arede22/voice-activated-car/README.md

# Voice Activated Car

Part of UC-Berkeley lab curriculum of EE16B to use newly learned applications of SVD and PCA along with circuit building to culminate in a voice-activated car. 

All relevant information in comprehensive lab report pdf.

<div align="center">
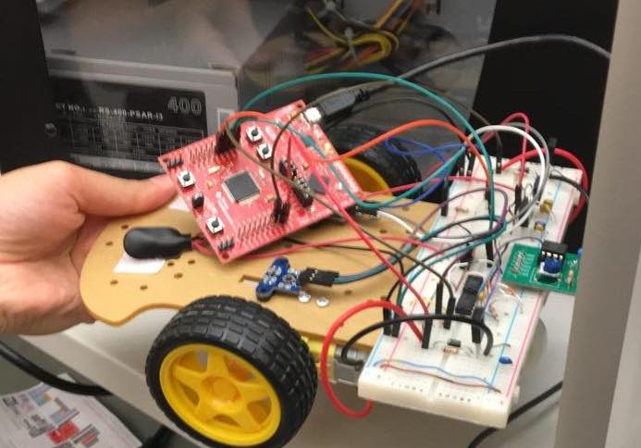
[picture p1: images/charlie.jpg]
  

  <p> Our last day with our robot, Charlie! </p>
</div>

<div align="center">
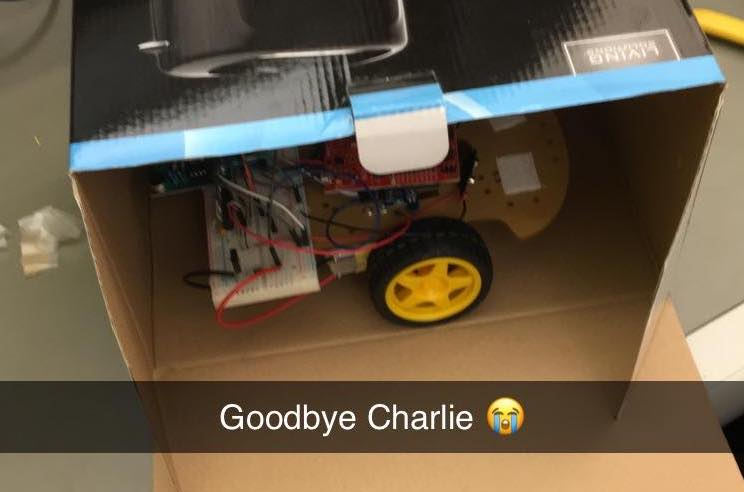
[picture p2: images/goodbye.jpg]
  

  <p> Saying goodbye until modifications in next semester! </p>
</div>

<div align="center">
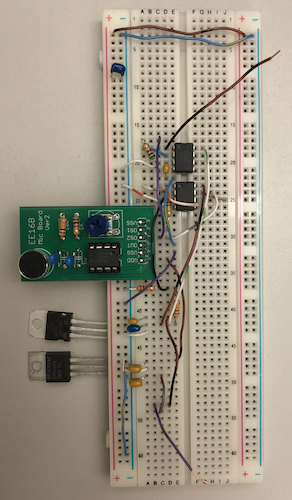
[picture p3: images/circuit1.png]
  

  <p> Front-end circuit laid down </p>
</div>

<div align="center">
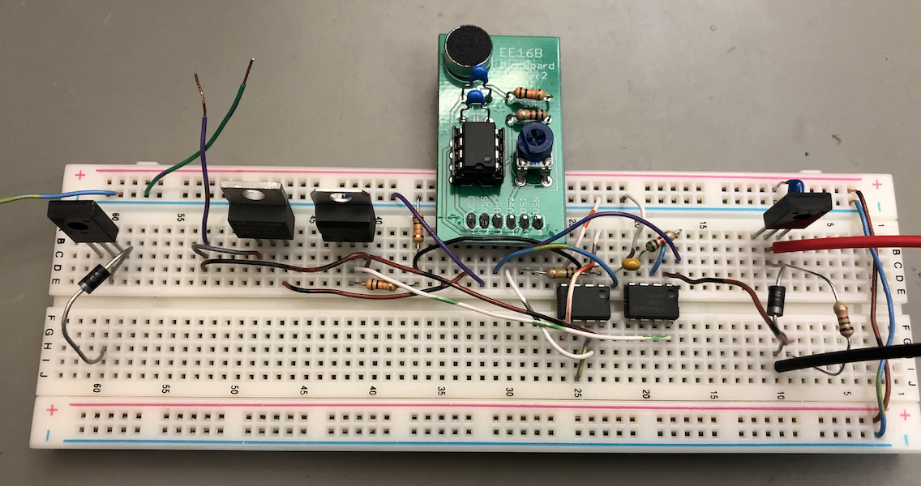
[picture p4: images/circuit2.png]
  

  <p> Front-end circuit connected to motors </p>
</div>

<div align="center">
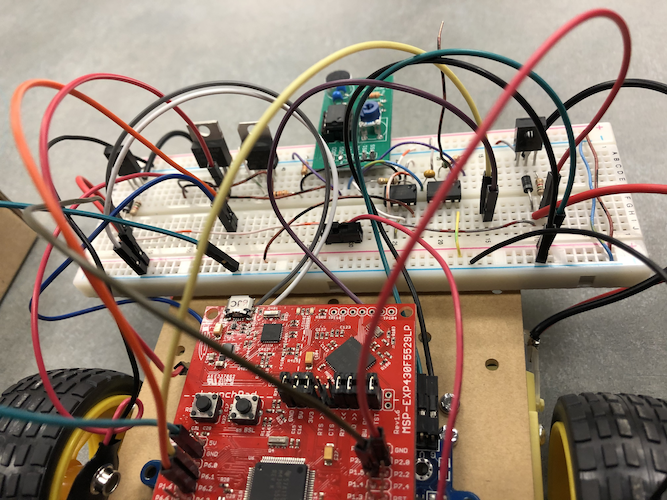
[picture p5: images/circuit3.png]
  

  <p> Pre-training lay-of-the-land </p>
</div>

<div align="center">
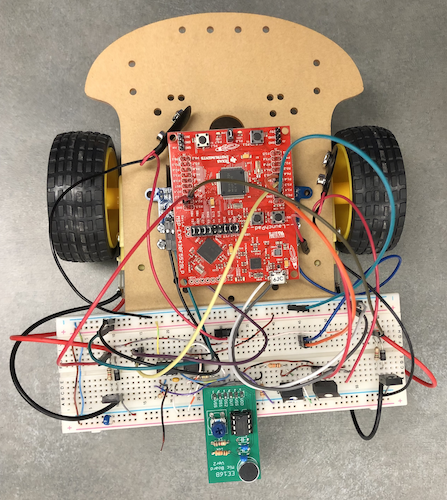
[picture p6: images/circuit4.png]
  

  <p> Whole voice-activated car </p>
</div>

<div align="center">
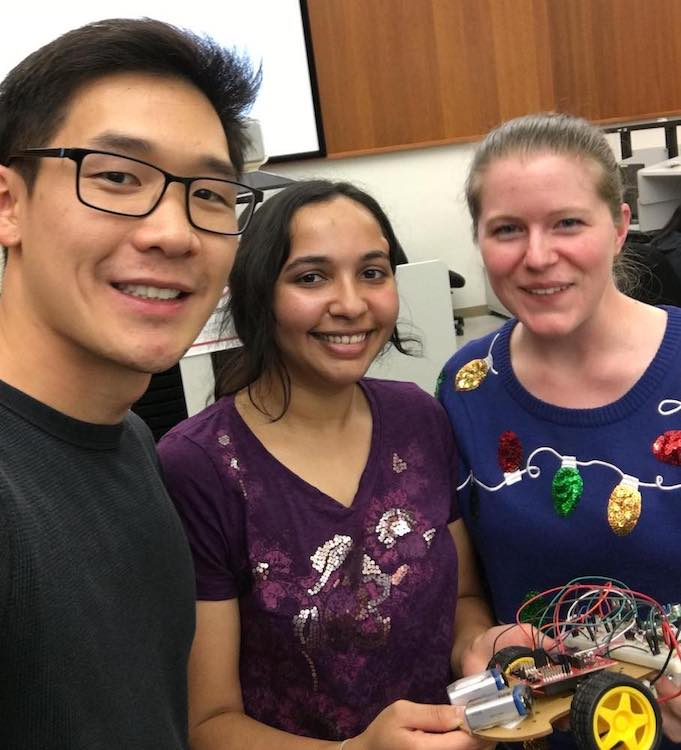
[picture p7: images/team.jpg]
  

  <p> Whole team together: Hua Chan Zhuo, Head Lab Assistant Maggie Payne, and me! </p>
</div>
