arede22/voice-activated-car/5-classification-controls/note_project_5_fa19.pdf

EE 16B | Designing Information Devices and Systems II
Fall 2019 | Anant Sahai | Project Note 5

Advanced Controls

In the controls lab, we used feedback control to minimize the difference in distance traveled between the two wheels (δ[n] = dL[n]−dR[n]). When perturbations cause one wheel to get ahead of the other, the feedback controller adjusts the left and right inputs to correct the error. So, when δ is nonzero, the controller turns the car to send δ back to zero. We can exploit this to make the car turn in a controlled fashion.
Recall that our inputs are:

uL[n] = v

∗ +βL

θL

−

kL
θL

δ[n]

uR[n] = v

∗ +βR

θR

+

kR
θR

δ[n]

Note that the first term in each input is always constant, while the second changes over time due to feedback. Let’s say the right wheel has moved more than the left (dR[n] > dL[n]), so δ is negative. This causes uR[n] to decrease and uL[n] to increase, thereby correcting the disturbance. However, if we artificially increase δ’s magnitude by some factor, this would cause uR[n] to decrease and uL[n] to increase past the point of straightness: put differently, it causes the car to turn right (if the car’s left wheel has travelled further than the right wheel, the car is turning right). Let’s explore this idea more formally.

Turning via Reference Tracking

We would like the car to turn with a specific radius r and velocity v

∗
. To turn smoothly, we want δ to change at a particular rate: rather than just adding a constant offset to δ, we will include a time-dependent reference factor, making δ a function of turn radius r, velocity v∗, time n, and distance bw the car wheels in centimeters l. Each tick corresponds to approximately 1cm of wheel circumference, so l = d.
1. What radius would we use if we want the car to go straight?
2. Inspect the figure below. Write δ[n] as a function of r, v

∗
, l, n using the following variables: n - timestep
r [cm] - turning radius
d [ticks] - distance traveled by the center of the car
l [cm] - distance between the centers of the car’s wheels ω [radians/tick] - angular velocity
θ - angle traveled
Hint: you will find the formula for arc length useful.

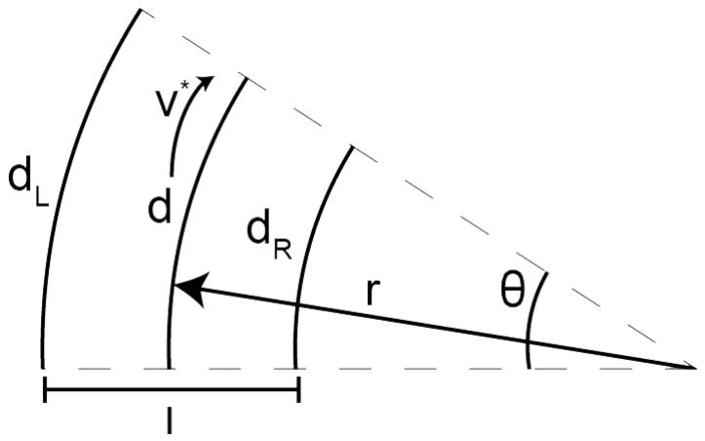
[picture p15: figure]

1 | Project Note 6 — Advanced Controls (v0.1)

EE 16B | Designing Information Devices and Systems II
Fall 2019 | Anant Sahai | Project Note 5

Implementing Turns

Before actually implementing turning on the Launchpad, we need to take into account the fact that the sampling periods of our encoders (aka data collection) and our control loop might be different. We’ll denote the data collection period by Td, and the control period by Tc. To see how this fits into your calculated turning reference, note that the units of v

∗
are ticks/Td and the units of n are seconds/Tc, or equivalently, ticks: Tc is in seconds, so since we know n is in ticks, we can restate it as seconds/Tc for easier conversion.
Td is an integer multiple of Tc, and we’ll define another variable m as

Td
Tc

. In our case, Tc = 100ms, and Td = 500ms, so m = 5. Therefore, we replace v

∗ with v

∗
m

, which is in units of ticks/Tc.

Now you are ready to finish the lab! Go to the Jupyter notebook and follow the instructions to do so.

Notes written by Mia Mirkovic (2019)

2 | Project Note 6 — Advanced Controls (v0.1)
