arede22/voice-activated-car/4-pca-training/note10_project5_fa19.pdf

EE 16B | Designing Information Devices and Systems II
Fall 2019 | Anant Sahai | Project Note 5

Voice Command Classification with PCA

Introduction

Data Collection and Processing

In order for S1XT33N to be able to differentiate between the commands you give it, the voice command signals must be linearly independent. This is easy — any real, recorded audio signal necessarily has some amount of approximately white noise, and therefore it is highly unlikely that you will be able to generate two linearly dependent signals. However, this is not actually a good thing for our purposes: it is nearly impossible to generate the exact same signal by recording a voice command twice, due to variations in your intonation, timing, and ambient noise. So, we want to choose commands that generate signals that are as close to orthogonal as possible.
To do this, we will use PCA, which is an application of the SVD. It highlights strong patterns in the dataset on which it is applied by projecting the dataset onto a basis that emphasizes variation. This way, when we project our collected signals on the PCA basis we generate from our training samples, the signals corresponding to each command should fall in a clear cluster, allowing S1XT33N to easily classify the commands.

Review of SVD and PCA

Singular Value Decomposition
The SVD decomposes any m x n, rank r matrix A into a sum of r rank-1 matrices:

A = σ1~u1~v

T
1 +σ2~u2~v

T
2 +...+σr~ur~v

T
r

such that:

1. The set of vectors {~u1,~u2,...,~ur} is orthonormal.
2. The set of vectors {~v1,~v2,...,~vr} is orthonormal.
3. σ1 ≥ σ2 ≥ ... ≥ σr ≥ 0

The last restriction is imposed to ensure the uniqueness of the set {σ1,σ2,...,σr}. We will discuss this further later.
We can express this in matrix form as follows:

A = UΣV

T

. Let’s develop this expression from the initial sum A = σ1~u1~v

T
1 +σ2~u2~v

T
2 +...+σr~ur~v

T
r
Let U1 be the matrix formed by joining the column vectors {~u1,~u2,...,~ur}, and let V1 be the matrix formed by joining the column vectors {~v1,~v2,...,~vr}. We can now define a diagonal matrix S, where the values {σ1,σ2,...,σr} are on the diagonal. S, therefore, must be an r x r matrix (since it is diagonal and we have r values σ). Now, we can rephrase the sum
A = σ1~u1~v

T
1 +σ2~u2~v

T
2 +...+σr~ur~v

T
r
as the matrix multiplication

A = U1SVT
1 =
~u1 | ~u2 | ... ~ur

σ1 | 0
0 | σr

~v1 | ~v2 | ... ~vr

T
, U1 is m×r, V

T
1

is r ×n

Since {~v1,~v2,...,~vr} and {~u1,~u2,...,~ur} are orthonormal, U

T
1 U1 = V

T
1 V1 = Ir×r
This, however, is still not the full matrix form of the SVD. An advantage of the SVD is that it provides compression when the matrix A we are trying to decompose is not full rank (this is one of its primary use cases — this includes any time the A is not a square matrix). Since r ≤ m, U1 will not necessarily span the full m-dimensional space (nor will V1 necessarily span the full n-dimensional space). The full matrix form of SVD is as follows:

A = UΣV

T =

U1 U2

S | 0
0 | 0

V1 V2

T

1 | Project Note 5 — SVD/PCA (v0.1)

Fall 2019 | Anant Sahai | Project Note 5

where U1 and V1 are the matrices we defined earlier.
So, what are U2 and V2? To motivate this, let’s find {~u1,~u2,...,~ur} and {~v1,~v2,...,~vr} that satisfy the requirements we posed earlier.
Each rank-1 matrix is given by ~u~v

T
, where ~u is a column vector and~v is a row vector. The set of column vectors {~u1,~u2,...,~ur} is the set of eigenvectors of AAT and the set of row vectors {~v1,~v2,...,~vr} is the set of eigenvectors of A

TA.
While A can be any shape, AAT
and A

TA are both square, symmetric, and positive semidefinite. We can use these properties to our advantage: the symmetry of AAT and A

TA ensures that both sets of eigenvectors ~ui and~vi are orthogonal.
Let’s begin our review of the SVD with a toy example: the SVD for 2x2 matrices. Please consult this excellent article for a walkthrough if you feel you need it.

Principal Component Analysis

PCA Let X and Y be m x n matrices related by a linear transformation P, where X is the original dataset and Y is a re-representation of that dataset. P, therefore, is a change-of-basis matrix: the rows of P define a new basis for the columns of X.

PX = Y

We assume that P is orthonormal.

The fundamental question PCA asks is: How do we construct the “best” new basis for our dataset from a linear combination of its original basis vectors? Our judgment of the “best” basis clearly depends on which features we would like the re-expressed dataset to exhibit. We want to make recordings of different words look as different as possible to the MSP, so we
Let’s consider the limitations of our signal-processing system (the combination of your mic board, front-end circuit, and MSP). We know the MSP has very limited memory, and that your mic board isn’t exactly hi-fidelity. Therefore, we would like to minimize noise and redundancy so that we can keep the minimum amount of data in the MSP’s memory that will still allow us to classify our commands successfully.
Let’s address our desire to eliminate as much redundancy as possible from our dataset. We can quantify the redundancy within our dataset by calculating the covariance matrix.

Variance Consider two signal vectors A = {a1,a2,...,an} and B = {b1,b2,...bn}. The individual variances of A and B are defined as follows:

σ

2
A = hA,Ai | σ

2
| B = hB,Bi

Covariance The basic properties of covariance define a valid inner product on the vector space L

2
. Hence, the
covariance of two random variables can be expressed as the inner product of the corresponding centered (a.k.a., demeaned) variables. This is why we need to demean our dataset; otherwise, the inner product operation implicit in the matrix multiplication would not be equivalent to finding the covariance of each pair of vectors.

cov(X,Y) = hX −E(X),Y −E(Y)i

So, returning to our vectors A and B, we can define their covariance σ

2
A,B

as

σ

2
A,B =

1
n−1

hA,Bi

, where the term 1
n−1

is a normalizing factora

aWe use 1
n−1

instead of 1
n

to normalize because the latter provides a biased estimation of variance for small n. The proof that 1
n−1

is
the correct normalization for the unbiased estimator is out-of-scope, but we encourage you to look it up if you like.

Fall 2019 | Anant Sahai | Project Note 5

Let’s construct our A matrix by horizontally stacking our signal vectors (so that each row represents one recording, and each column represents one timestep). Now, using the definition of covariance we defined above, we can construct the covariance matrix SA as follows:

SA =

1
n−1

AAT

Note how the i jth element of SA is the covariance between recording i and recording j (or the variance, if i = j). Thus, the terms on the diagonal of the matrix are the variances, while the off-diagonal terms are covariances. A large covariance between a pair of recordings corresponds to a high degree of redundancy, while a covariance of zero corresponds to orthogonality (no redundancy). SA describes all relationships between pairs of recordings.

Something to ponder: how can we manipulate SA to further reduce redundancy?

In order to reduce redundancy, we want to minimize the covariance between the measurements. Optimally, all the covariances would be zero. We want to find a change of basis that gets us this result. Recall the structure we observed in the previous paragraph: if all the covariances are zero, the matrix SA will be diagonal. So, we will now diagonalize SA while taking into account the following assumptions made by PCA:

- PCA assumes that all basis vectors are orthonormal.
- PCA assumes that the directions corresponding to the largest variances are the most important.

You can probably guess what comes next: what’s an easy way to diagonalize a matrix that also yields an orthonormal basis? Yep — we’re going to use the eigendecomposition again.
Note that SA was generated by finding AAT
, which implies that SA is symmetric (try to prove this). Since we know a symmetric matrix is diagonalized by a matrix of its orthonormal eigenvectors, we can assert that for a symmetric matrix SA,
SA = EDET
(1)

where D is a diagonal matrix and E is a matrix whose columns are the eigenvectors of SA. We will now construct P so that each row is an eigenvector of AAT
. From this construction, it follows that P = E

T
. Substituting this P into equation (1) yields

SA = P

TDP

PCA Procedure:
1. Construct the initial data matrix A such that the rows of A represent different recordings, and the columns of A represent different timesteps.
2. Demean the matrix A along its columns.
3. Calculate the SVD or the eigenvectors of the covariance matrix.

References

Slides by Miki Lustig (https://inst.eecs.berkeley.edu/ ee16b/fa18/lectures/Lecture9A.pdf)
Linear Algebra, Fourth Edition. Friedberg, Insel, and Spence.
An Article on SVD and its Applications. (http://www.ams.org/publicoutreach/feature-column/fcarc-svd) Vector Spaces of Random Variables. (https://www.randomservices.org/random/expect/Spaces.html)

Notes written by Mia Mirkovic (2019)
