arede22/voice-activated-car/1-front-end-circuit/images/5vreg-po.png

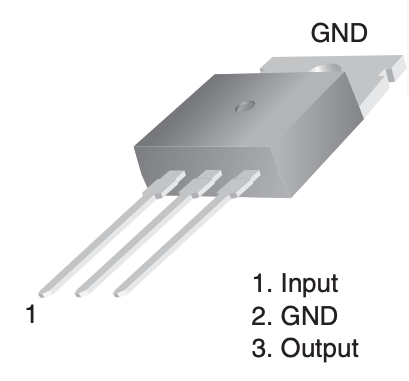
1-front-end-circuit/images/5vreg-po.png
