arede22/voice-activated-car/1-front-end-circuit/images/33vreg-ckt.png

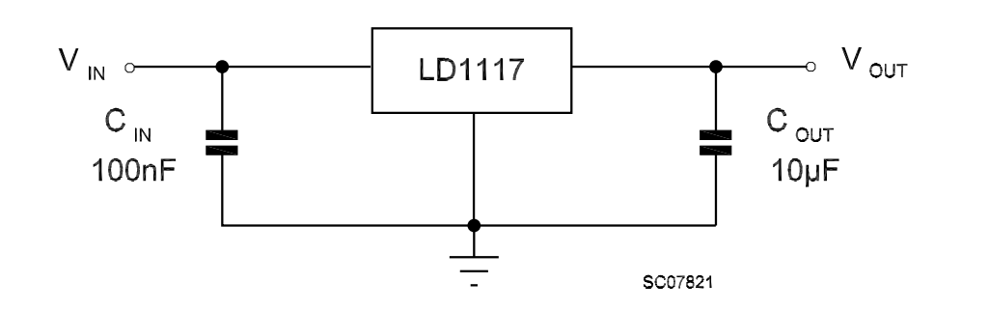
1-front-end-circuit/images/33vreg-ckt.png
