arede22/voice-activated-car/1-front-end-circuit/images/33vreg-sketch.png

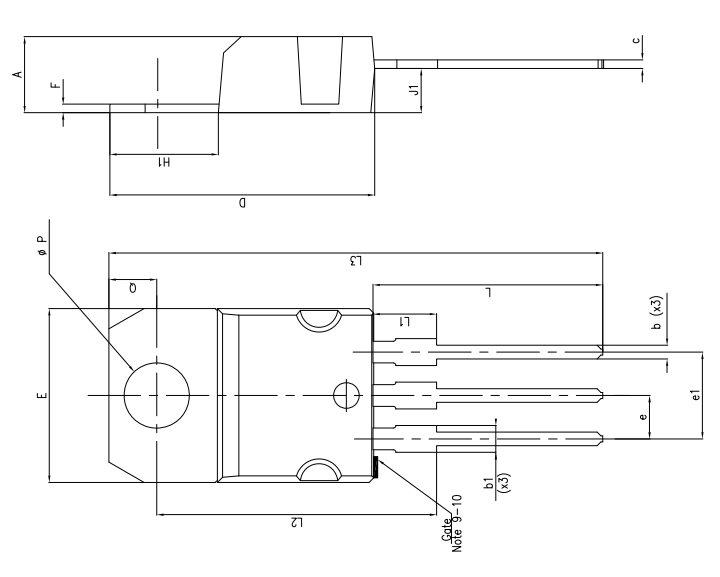
1-front-end-circuit/images/33vreg-sketch.png
