arede22/voice-activated-car/1-front-end-circuit/images/bandpass.png

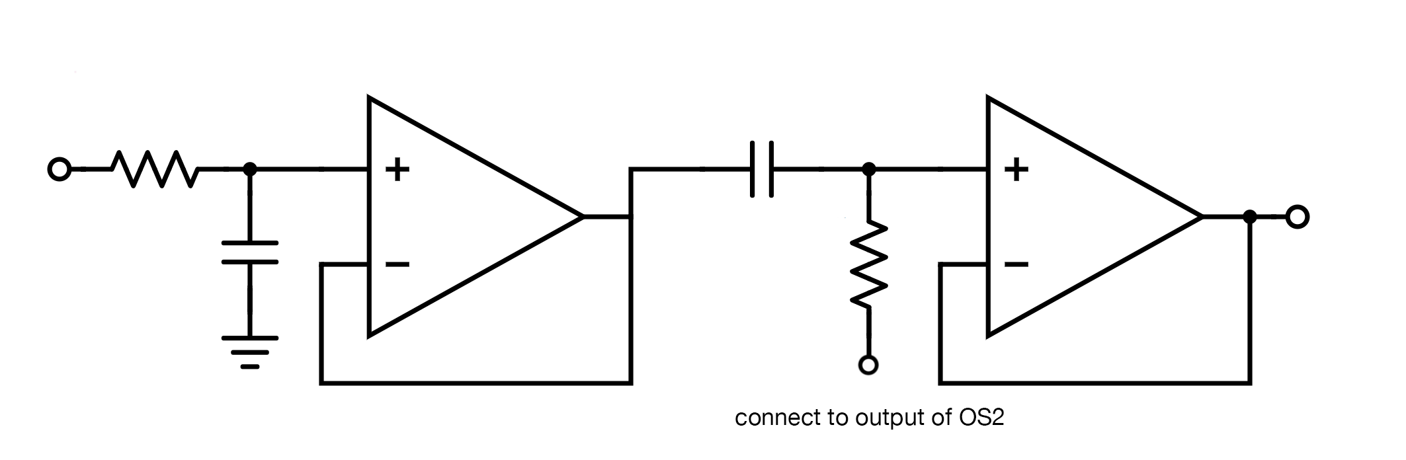
1-front-end-circuit/images/bandpass.png
