arede22/voice-activated-car/1-front-end-circuit/images/BiasCircuit_V2.png

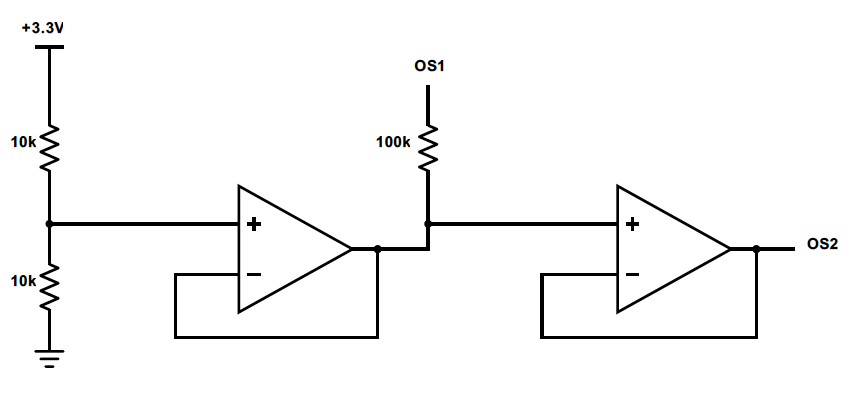
1-front-end-circuit/images/BiasCircuit_V2.png
