arede22/voice-activated-car/1-front-end-circuit/images/circuit_outline_diagram_v2_with_voltage_reg_single_cap.png

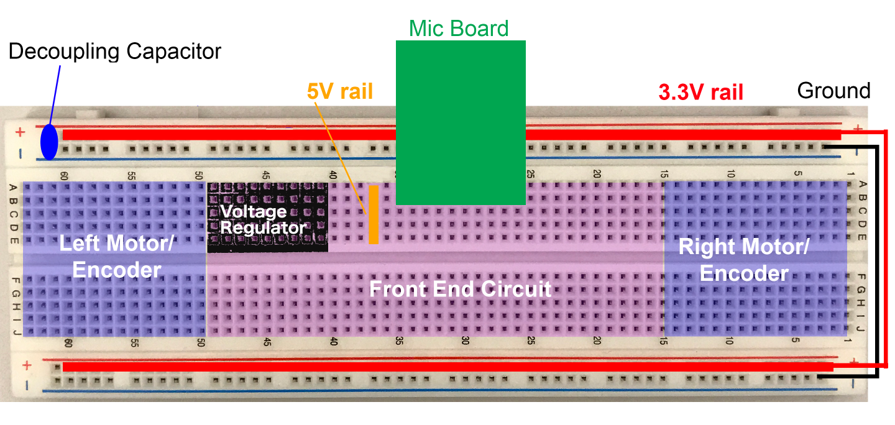
1-front-end-circuit/images/circuit_outline_diagram_v2_with_voltage_reg_single_cap.png
