arede22/voice-activated-car/1-front-end-circuit/images/Highpass.png

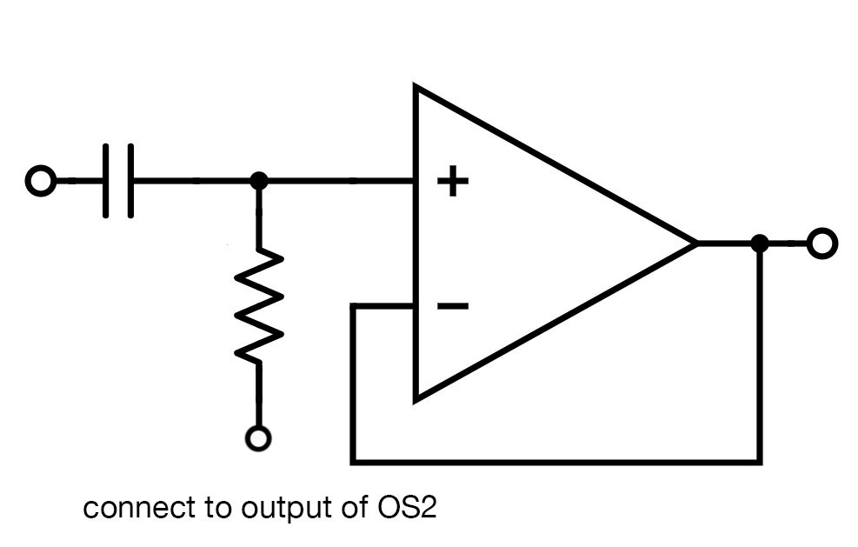
1-front-end-circuit/images/Highpass.png
