arede22/voice-activated-car/1-front-end-circuit/images/inside-potentiometer.jpg

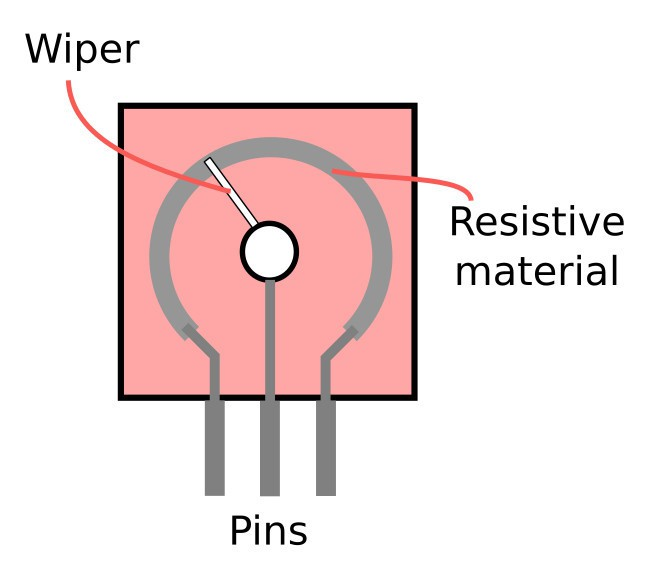
1-front-end-circuit/images/inside-potentiometer.jpg
