arede22/voice-activated-car/1-front-end-circuit/images/lmp.png

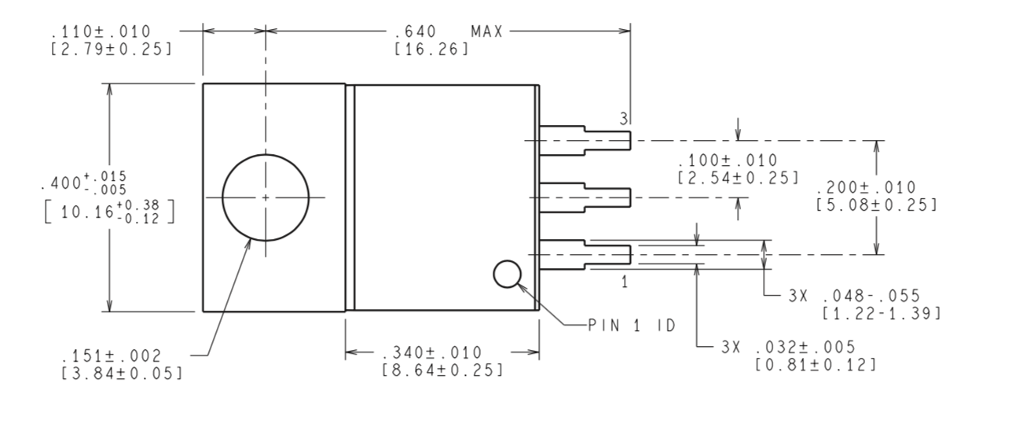
1-front-end-circuit/images/lmp.png
