arede22/voice-activated-car/1-front-end-circuit/images/MicBoardSchematic_pot_overlay.png

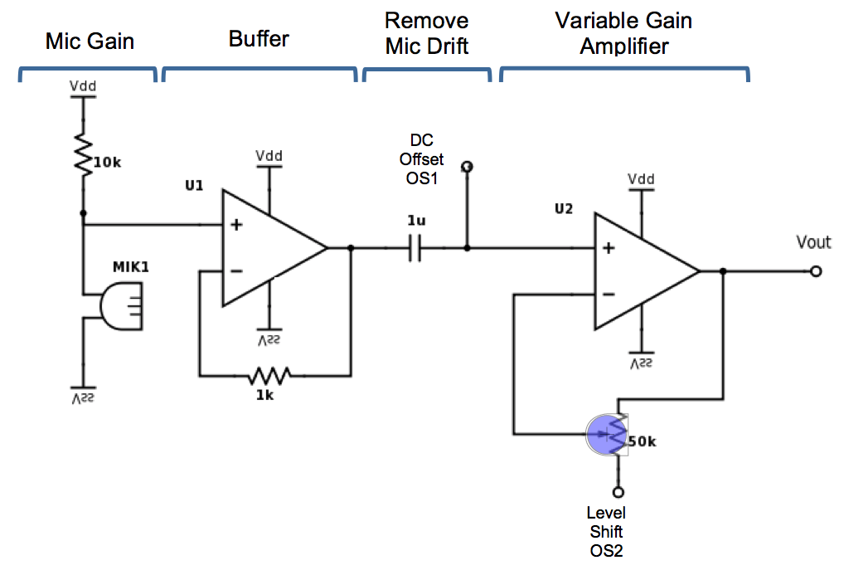
1-front-end-circuit/images/MicBoardSchematic_pot_overlay.png
