arede22/voice-activated-car/1-front-end-circuit/images/motor-drive-with-switch.jpg

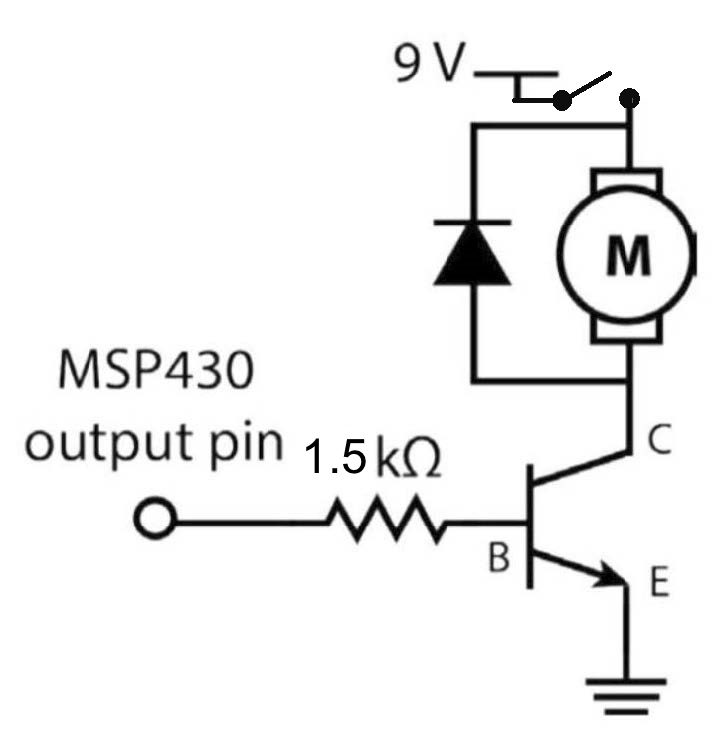
1-front-end-circuit/images/motor-drive-with-switch.jpg
