arede22/voice-activated-car/1-front-end-circuit/images/pot.png

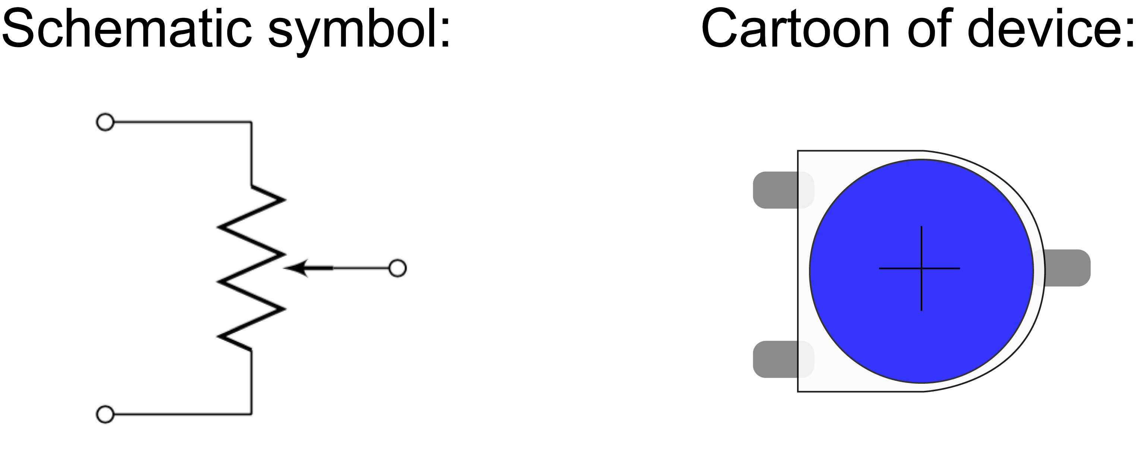
1-front-end-circuit/images/pot.png
