arede22/voice-activated-car/1-front-end-circuit/images/proj-bjt.png

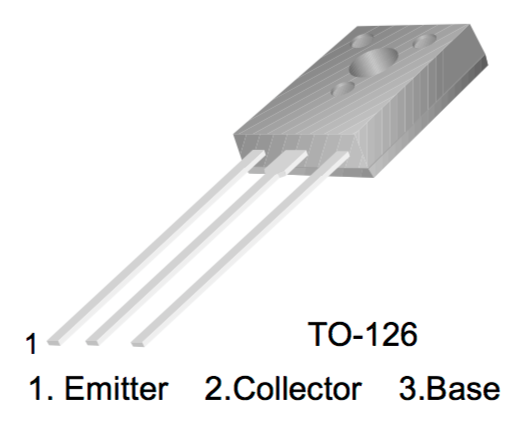
1-front-end-circuit/images/proj-bjt.png
