arede22/voice-activated-car/1-front-end-circuit/images/proj-car-encoder1.jpg

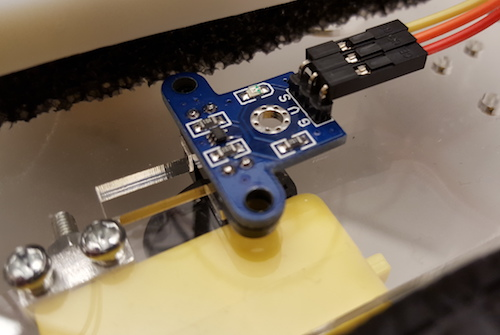
1-front-end-circuit/images/proj-car-encoder1.jpg
