arede22/voice-activated-car/1-front-end-circuit/images/proj-diode.png

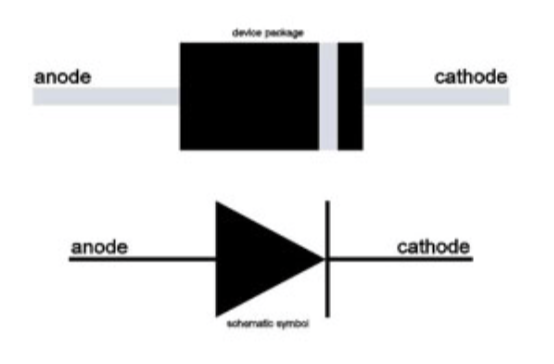
1-front-end-circuit/images/proj-diode.png
