arede22/voice-activated-car/1-front-end-circuit/images/proj-power.png

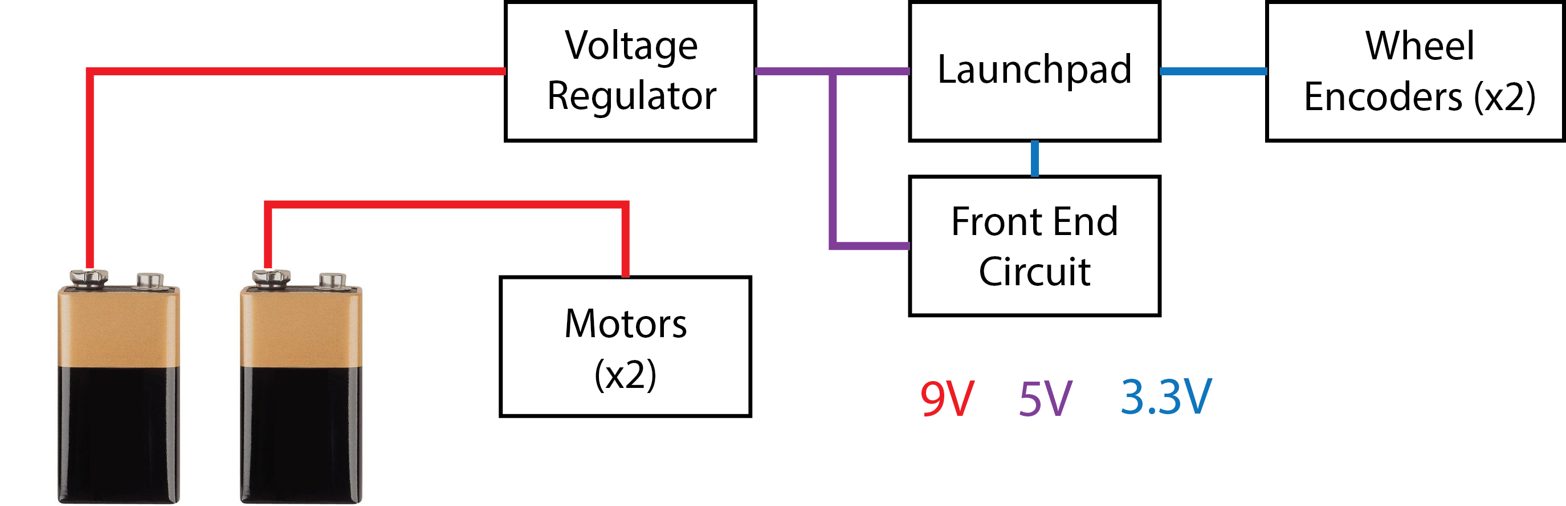
1-front-end-circuit/images/proj-power.png
