arede22/voice-activated-car/1-front-end-circuit/images/voltage_reg.png

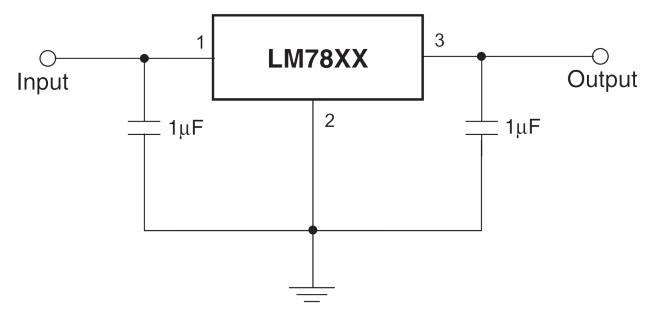
1-front-end-circuit/images/voltage_reg.png
