arede22/voice-activated-car/2-open-loop/images/5vjumper.jpg

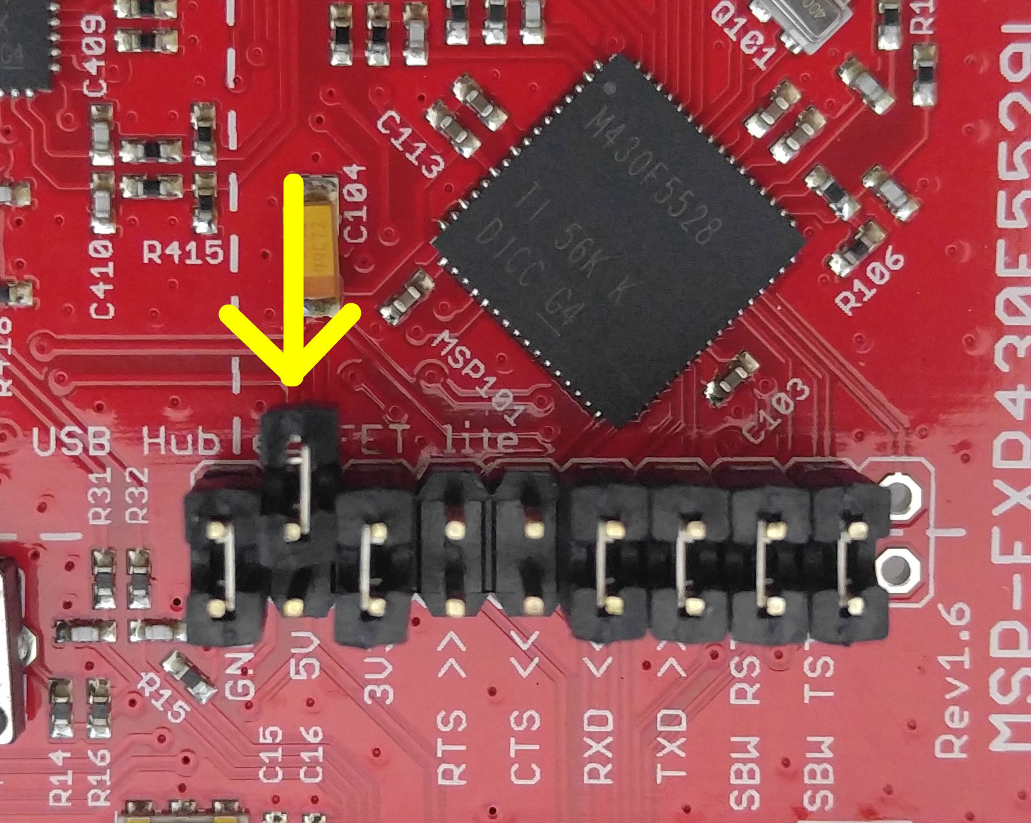
2-open-loop/images/5vjumper.jpg
