arede22/voice-activated-car/2-open-loop/images/example_coarse_data.png

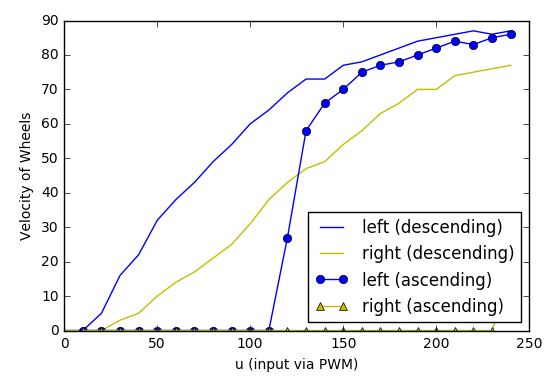
2-open-loop/images/example_coarse_data.png
