arede22/voice-activated-car/2-open-loop/images/IMG_0301.jpeg

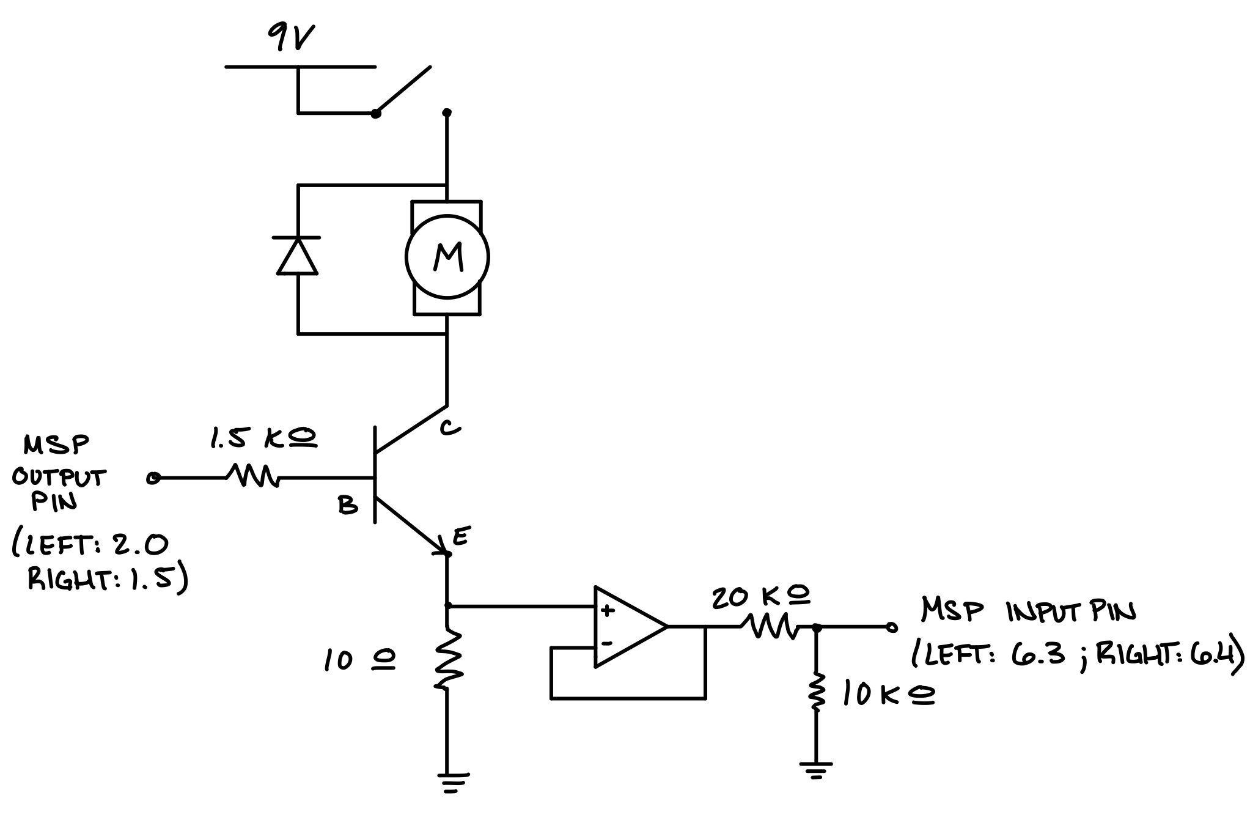
2-open-loop/images/IMG_0301.jpeg
