arede22/voice-activated-car/2-open-loop/images/IMG_0306.jpeg

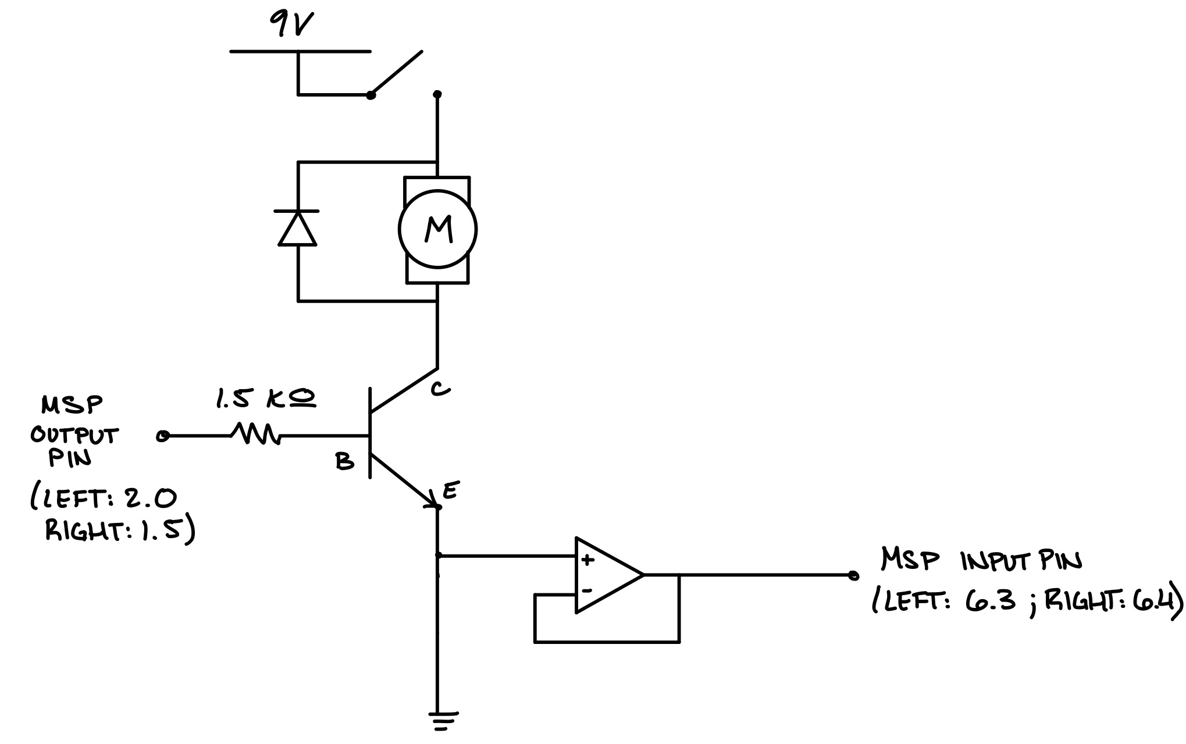
2-open-loop/images/IMG_0306.jpeg
