arede22/voice-activated-car/2-open-loop/images/partial_overlap_lsq.png

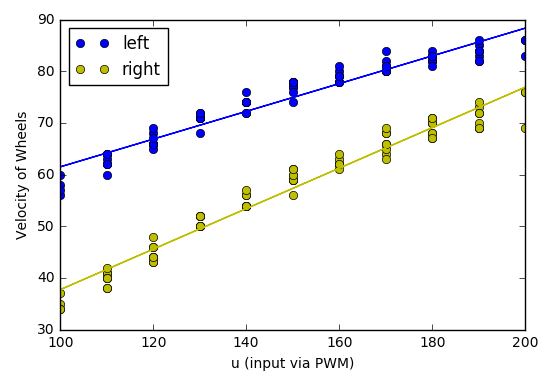
2-open-loop/images/partial_overlap_lsq.png
