arede22/voice-activated-car/2-open-loop/images/PowerDiagram1.png

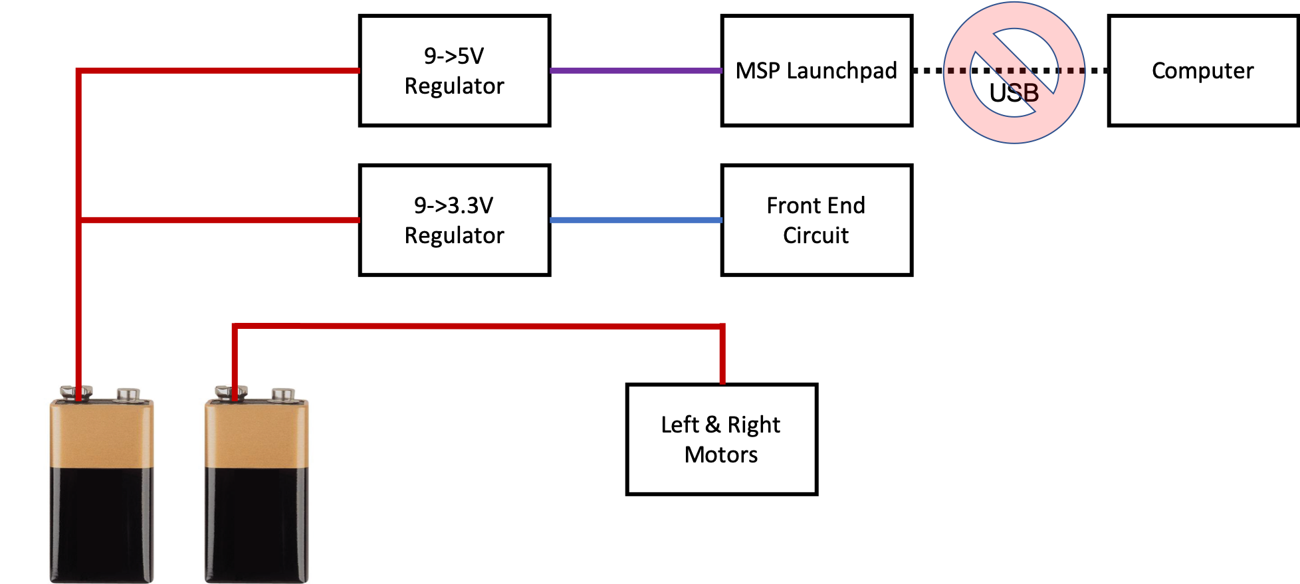
2-open-loop/images/PowerDiagram1.png
