arede22/voice-activated-car/2-open-loop/images/PowerDiagram2.png

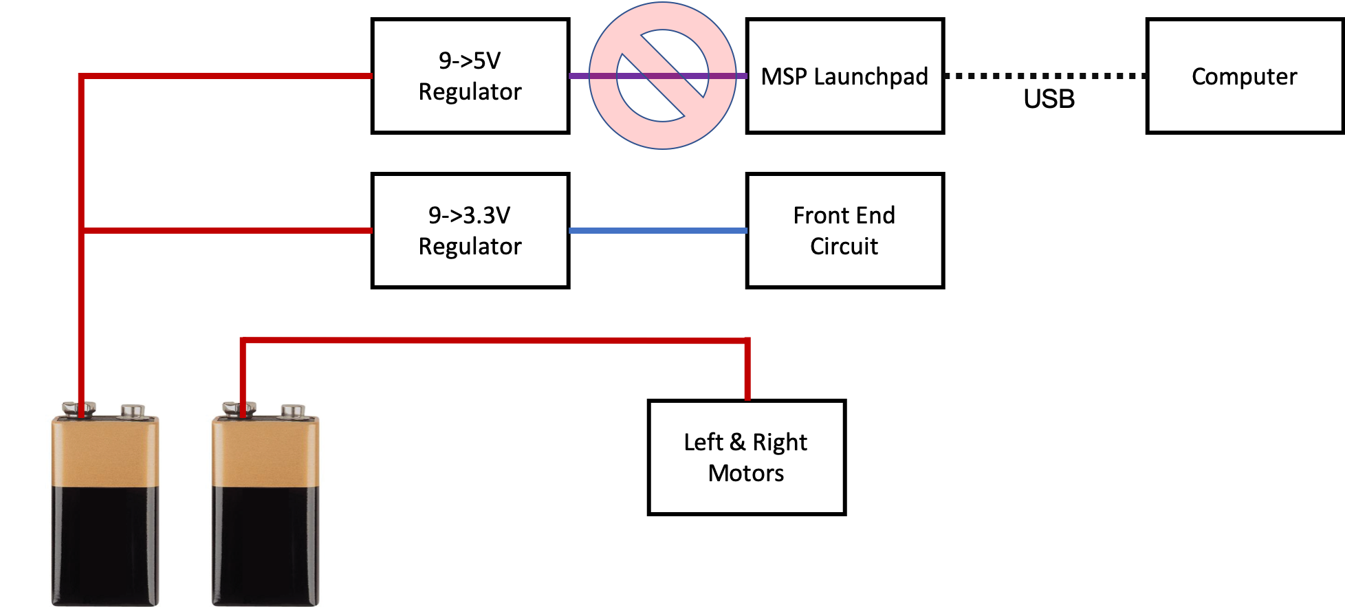
2-open-loop/images/PowerDiagram2.png
