arede22/voice-activated-car/2-open-loop/images/proj-batt-lead.jpg

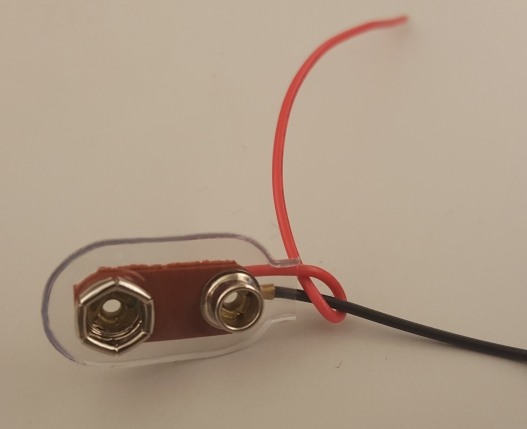
2-open-loop/images/proj-batt-lead.jpg
