arede22/voice-activated-car/3-closed-loop/images/VoltageRegulatorCircuit.png

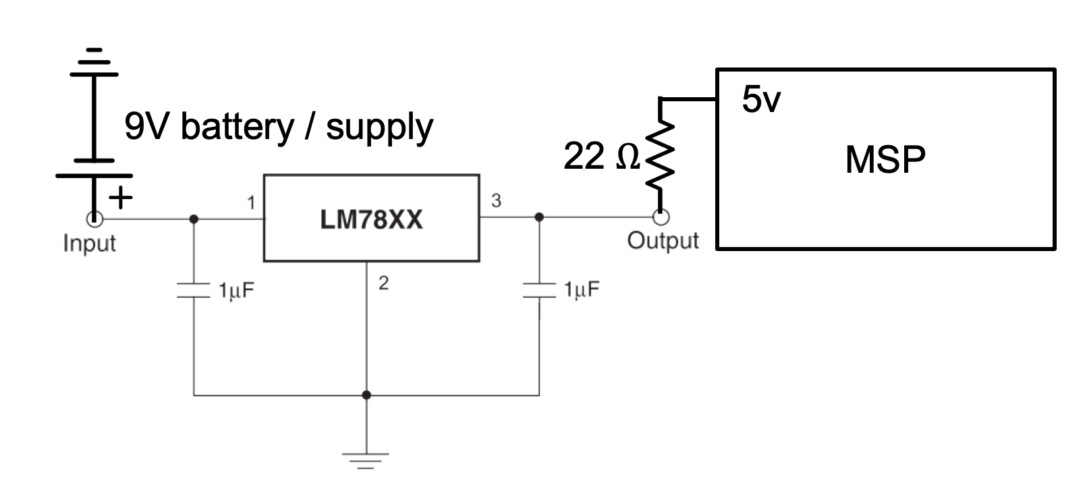
3-closed-loop/images/VoltageRegulatorCircuit.png
