arede22/voice-activated-car/4-pca-training/images/msp-jumpers.png

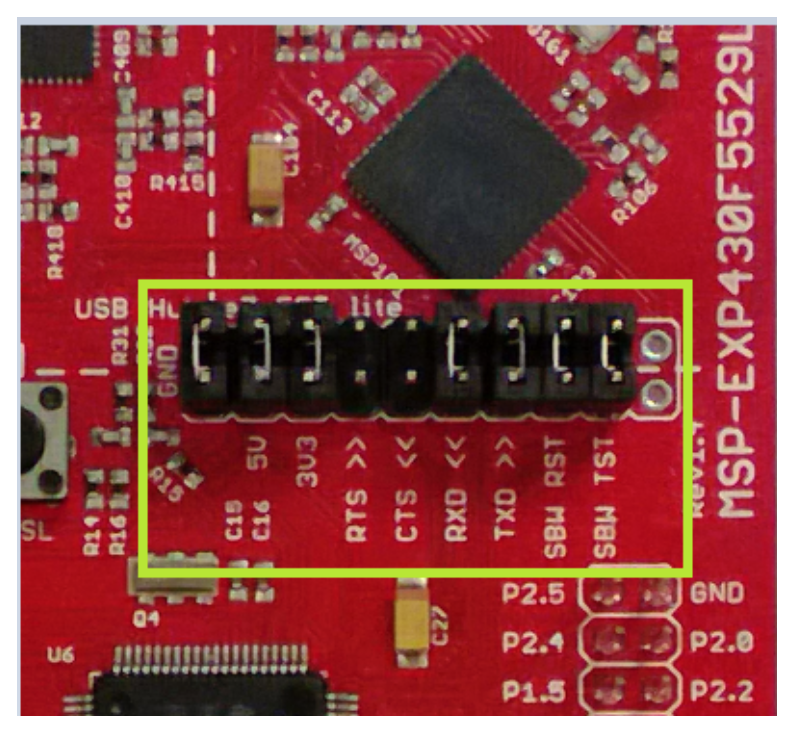
4-pca-training/images/msp-jumpers.png
