arede22/voice-activated-car/4-pca-training/images/proj-envelope.png

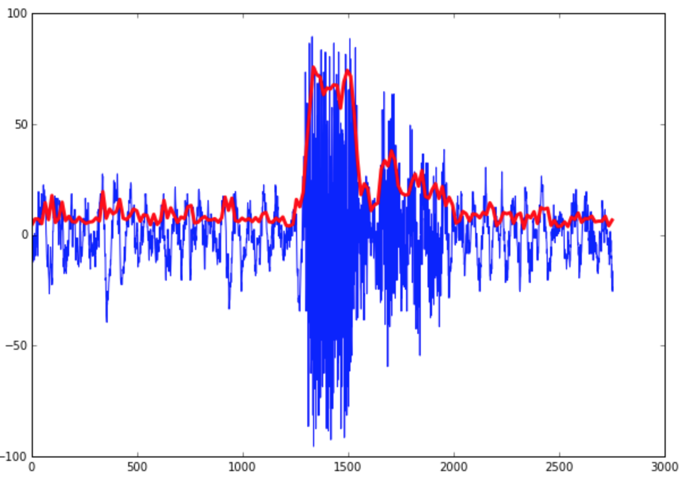
4-pca-training/images/proj-envelope.png
