arede22/voice-activated-car/4-pca-training/images/proj-waveform.png

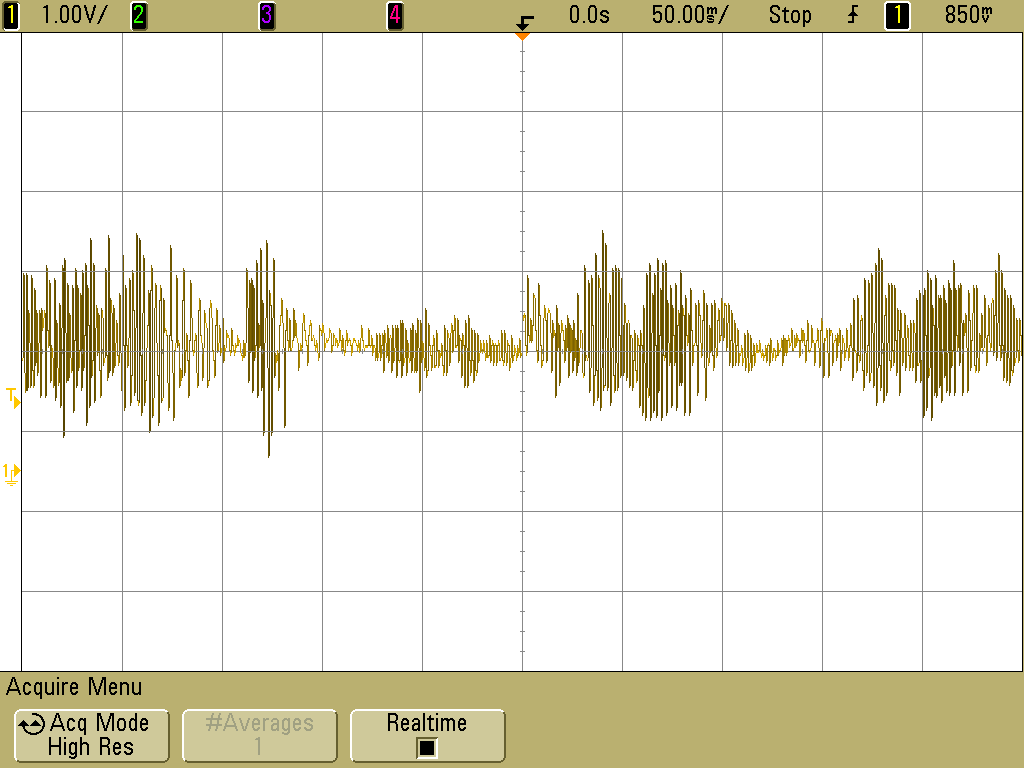
4-pca-training/images/proj-waveform.png
