arede22/voice-activated-car/6-integration/integration/integration.ino

/*
 * integration.ino
 * Final sketch for SIXT33N Speech version
 *
 * EE16B Fall 2016
 * Emily Naviasky & Nathaniel Mailoa
 *
 * EE 16B Fall 2017
 * Andrew Blatner
 *
 */

/********************************************************/
/********************************************************/
/***                                                  ***/
/*** Constants and global variables from turning.ino. ***/
/***                                                  ***/
/********************************************************/
/********************************************************/

#define LEFT_MOTOR                  P2_0
#define LEFT_ENCODER                P6_1
#define RIGHT_MOTOR                 P1_5
#define RIGHT_ENCODER               P6_2

#define SAMPLING_INTERVAL           100
int sample_lens[4] = {0};

// Operation modes
#define MODE_LISTEN                 0
#define MODE_DRIVE                  1
int timer_mode = MODE_LISTEN;

#define DRIVE_FAR                   0 // cat
#define DRIVE_LEFT                  1 // green bean
#define DRIVE_CLOSE                 2 // sad bears
#define DRIVE_RIGHT                 3 // charlie

#define JOLT_STEPS                  2

boolean loop_mode = MODE_DRIVE;
int drive_mode = 0;

int step_num = 0;
volatile boolean do_loop = 0; // timer signal to increment timestep

typedef struct encoder {
  int pin;
  int pos;
  bool level;
  int avg;
} encoder_t;

encoder_t left_encoder = {LEFT_ENCODER, 0, LOW, 0};
encoder_t right_encoder = {RIGHT_ENCODER, 0, LOW, 0};

/*---------------------------*/
/*      CODE BLOCK CON1      */
/*      From turning.ino     */
/*---------------------------*/

float theta_left = 0.5468;
float theta_right = 0.632;
float beta_left = 21.18;
float beta_right = 52.77;
float v_star = 53.6;

// PWM inputs to jolt the car straight
int left_jolt = 150;
int right_jolt= 190;

// Control gains
float k_left = 0.7;
float k_right = 0.75;

/*---------------------------*/
/*      CODE BLOCK CON2      */
/*      From turning.ino     */
/*---------------------------*/

float driveStraight_left(float delta) {
  return ((v_star + beta_left) - (k_left*delta))/theta_left;
}

float driveStraight_right(float delta) {
  return ((v_star + beta_right) + (k_right*delta))/theta_right;
}

/*---------------------------*/
/*      CODE BLOCK CON3      */
/*      From turning.ino     */
/*---------------------------*/

float delta_ss = -7;

/*---------------------------*/
/*      CODE BLOCK CON4      */
/*      From turning.ino     */
/*---------------------------*/

#define CAR_WIDTH                   15.0 // in cm
#define TURN_RADIUS                 91 // in cm - 6 feet diameter = 3 tiles in 125 Cory
// #define TURN_RADIUS                 60 // in cm - 4 feet diameter = 2 tiles in 125 Cory

int run_times[4] = {7000, 5000, 2500, 5000};

float delta_reference(int k) {
  // YOUR CODE HERE
  if (drive_mode == DRIVE_RIGHT) {
    return CAR_WIDTH*k*v_star/(TURN_RADIUS*5);
  }
  else if (drive_mode == DRIVE_LEFT) {
    return -CAR_WIDTH*k*v_star/(TURN_RADIUS*5);
  }
  else { // DRIVE_FAR, DRIVE_CLOSE
    return 0;
  }
}

/*---------------------------*/
/*      CODE BLOCK CON5      */
/*      From turning.ino     */
/*---------------------------*/
#define INFINITY                    (3.4e+38)
#define STRAIGHT_RADIUS             INFINITY

float straight_correction(int k) {
  // YOUR CODE HERE
  return CAR_WIDTH*k*v_star/(STRAIGHT_RADIUS*5);
}

/*---------------------------*/
/*---------------------------*/
/*---------------------------*/

/*********************************************************/
/*********************************************************/
/***                                                   ***/
/*** Constants and glboal variables from classify.ino. ***/
/***                                                   ***/
/*********************************************************/
/*********************************************************/

#define MIC_INPUT                   P6_0

#define SIZE                        2752
#define SIZE_AFTER_FILTER           172
#define ADC_TIMER_MS                0.35

/*---------------------------*/
/*      CODE BLOCK PCA1      */
/*     From classify.ino     */
/*---------------------------*/

// Enveloping and K-means constants
#define SNIPPET_SIZE                100 // reduce dim if out-of-memory error
#define PRELENGTH                   5
#define THRESHOLD                   0.6

#define KMEANS_THRESHOLD            0.045
#define LOUDNESS_THRESHOLD          1000

/*---------------------------*/
/*---------------------------*/
/*---------------------------*/


/*---------------------------*/
/*      CODE BLOCK PCA2      */
/*     From classify.ino     */
/*---------------------------*/

float pca_vec1[100] = {-0.046285687348, -0.0448866994267, -0.0447258262842, -0.0444718000176, -0.0975033748264, -0.15933506406, -0.164168638958, -0.19290879541, -0.203248686339, -0.211242930659, -0.211485847697, -0.211277889634, -0.214082617155, -0.191490764583, -0.216880979732, -0.206878210296, -0.189083248486, -0.206904254904, -0.206540835371, -0.183658775122, -0.189452625916, -0.152246254287, -0.172525139436, -0.130802158557, -0.0968991023281, -0.0862779432884, -0.0513024149089, -0.0471995881233, -0.0238933984925, -0.00305482835846, 0.017955639593, 0.0348661629223, 0.0381941698973, 0.0485520836543, 0.0460024998843, 0.0529574412522, 0.0573750115901, 0.0482648534306, 0.0572894630523, 0.0447349017185, 0.0570514640131, 0.0535328244399, 0.053795996953, 0.0630253325041, 0.0577057269514, 0.0629034170428, 0.0667116921519, 0.0686640057196, 0.0866476835745, 0.0777672224187, 0.0869658863054, 0.0772838410909, 0.0853745826038, 0.084566310353, 0.0819622962975, 0.0838766558654, 0.0705344184403, 0.0706356006325, 0.06715480654, 0.0641218833568, 0.0635379611984, 0.0538702778754, 0.0482897651462, 0.0567773760169, 0.0492564267145, 0.0467750448284, 0.0475188536071, 0.0519378456942, 0.0549924761579, 0.0550272761826, 0.0497887518146, 0.0548957025456, 0.056581131585, 0.0574923416218, 0.0616172772638, 0.0635796851409, 0.0596624538629, 0.0652586802157, 0.0559194702137, 0.0666646545842, 0.0622568638082, 0.0633316907515, 0.0632454223559, 0.0614660054058, 0.0643661134583, 0.0668554420963, 0.0653228502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
volatile int re_pointer = 0;

/*---------------------------------------------------*/
/*---------------------------------------------------*/
/*---------------------------------------------------*/

/*---------------------------*/
/*       Norm functions      */
/*---------------------------*/

// Compute the L2 norm of (dim1, dim2) and centroid
// input: dim1: 1st dimension coordinate
//        dim2: 2nd dimension coordinate
//        centroid: size-2 array containing centroid coordinates
// output: L2 norm (Euclidean distance) between point and centroid
float l2_norm(float dim1, float dim2, float* centroid) {
  return sqrt(pow(dim1-centroid[0],2) + pow(dim2-centroid[1],2));
}

// Compute the L2 norm of (dim1, dim2, dim3) and centroid
// input: dim1: 1st dimension coordinate
//        dim2: 2nd dimension coordinate
//        dim3: 3rd dimension coordinate
//        centroid: size-3 array containing centroid coordinates
// output: L2 norm (Euclidean distance) between point and centroid
float l2_norm3(float dim1, float dim2, float dim3, float* centroid) {
  return sqrt(pow(dim1-centroid[0],2) + pow(dim2-centroid[1],2) + pow(dim3-centroid[2],2));
}

void setup(void) {
  Serial.begin(38400);

  pinMode(LEFT_MOTOR, OUTPUT);
  pinMode(LEFT_ENCODER, INPUT);
  pinMode(RIGHT_MOTOR, OUTPUT);
  pinMode(RIGHT_ENCODER, INPUT);
  pinMode(RED_LED, OUTPUT);
  pinMode(GREEN_LED, OUTPUT);
  pinMode(MIC_INPUT, INPUT);

  for (int i = 0; i < 4; i++) {
    sample_lens[i] = run_times[i] / SAMPLING_INTERVAL;
  }

  write_pwm(0, 0);
  delay(2000); // Wait 2 seconds to put down car
  reset_blinker();
  start_listen_mode();
}

void loop(void) {
  check_encoders();
  if (timer_mode == MODE_LISTEN && re_pointer == SIZE){
    // Stop motor
    write_pwm(0, 0);
    digitalWrite(RED_LED, LOW);

    // if enveloped data is above some preset value
    if (envelope(re, result)) {

      // Reset projection result variables declared above
      proj1 = 0;
      proj2 = 0;
      proj3 = 0;

      /*---------------------------*/
      /*      CODE BLOCK PCA3      */
      /*     From classify.ino     */
      /*     with more changes     */
      /*---------------------------*/

      // Project 'result' on the principal components
      // YOUR CODE HERE
      for (int i = 0; i < SNIPPET_SIZE; i++) {
          proj1 += result[i]*pca_vec1[i];
          proj2 += result[i]*pca_vec2[i];
          proj3 += result[i]*pca_vec3[i];
      }

      // Demean the projection
      proj1 -= projected_mean_vec[0];
      proj2 -= projected_mean_vec[1];
      proj3 -= projected_mean_vec[2];

      // Classification
      // Use the function 'l2_norm' defined above
      // ith centroid: 'centroids[i]'
      float best_dist = 999999;
      int best_index = -1;
      // YOUR CODE HERE
      float arr[4] = {0, 0, 0, 0};
      for (int i = 0; i < 4; i++) {
          arr[i] = l2_norm3(proj1, proj2, proj3, centroids[i]);
          if (arr[i] < best_dist) {
            best_dist = arr[i];
            best_index = i;
          }
      }

      // Check against KMEANS_THRESHOLD and print result over serial
      // YOUR CODE HERE
      if (best_dist < KMEANS_THRESHOLD) {
        drive_mode = best_index; // from 0-3, inclusive
        start_drive_mode();
      }

      /*---------------------------*/
      /*---------------------------*/
      /*---------------------------*/
    }

    delay(2000);
    re_pointer = 0; // start recording from beginning if we don't start driving
  }

  else if (loop_mode == MODE_DRIVE && do_loop) {
    if (step_num < JOLT_STEPS) {
      write_pwm(left_jolt, right_jolt);
    }
    else {

      // Save positions because _left_position and _right_position
      // can change in the middle of one loop.
      int left_position = left_encoder.pos;
      int right_position = right_encoder.pos;

      /*---------------------------*/
      /*      CODE BLOCK CON0      */
      /*---------------------------*/

      float delta = left_position - right_position + delta_ss;
      delta = delta - delta_reference(step_num) - straight_correction(step_num);

      // Drive straight using feedback
      // Compute the needed pwm values for each wheel using delta and v_star
      int left_cur_pwm = driveStraight_left(delta);
      int right_cur_pwm = driveStraight_right(delta);
      write_pwm(left_cur_pwm, right_cur_pwm);

      /*---------------------------*/
      /*---------------------------*/
      /*---------------------------*/
    }

    // Counter for how many times loop is executed since entering DRIVE MODE
    step_num++;

    if (step_num == sample_lens[drive_mode]) {
      // Completely stop and go back to listen MODE after 3 seconds
      start_listen_mode();
    }

    do_loop = 0;
  }
}

// Enveloping function with thresholding and normalizing,
// returns snippet of interest (containing speech)
bool envelope(int* data, float* data_out) {
  int32_t avg = 0;
  float maximum = 0;
  int32_t total = 0;
  int block;

  // Apply enveloping filter while finding maximum value
  for (block = 0; block < SIZE_AFTER_FILTER; block++) {
    avg = 0;
    for (int i = 0; i < 16; i++) {
      avg += data[i+block*16];
    }
    avg = avg >> 4;
    data[block] = abs(data[block*16] - avg);
    for (int i = 1; i < 16; i++) {
      data[block] += abs(data[i+block*16] - avg);
    }
    if (data[block] > maximum) {
      maximum = data[block];
    }
  }

  // If not loud enough, return false
  if (maximum < LOUDNESS_THRESHOLD) {
    return false;
  }

  // Determine threshold
  float thres = THRESHOLD * maximum;

  // Figure out when interesting snippet starts and write to data_out
  block = PRELENGTH;
  while (data[block++] < thres);
  if (block > SIZE_AFTER_FILTER - SNIPPET_SIZE) {
    block = SIZE_AFTER_FILTER - SNIPPET_SIZE;
  }
  for (int i = 0; i < SNIPPET_SIZE; i++) {
    data_out[i] = data[block-PRELENGTH+i];
    total += data_out[i];
  }

  // Normalize data_out
  for (int i = 0; i < SNIPPET_SIZE; i++) {
    data_out[i] = data_out[i] / total;
  }

  return true;
}

/*---------------------------*/
/*     Helper functions      */
/*---------------------------*/

void write_pwm(int pwm_left, int pwm_right) {
  analogWrite(LEFT_MOTOR, (int) min(max(0, pwm_left), 255));
  analogWrite(RIGHT_MOTOR, (int) min(max(0, pwm_right), 255));
}

void reset_blinker(void) {
  digitalWrite(RED_LED, HIGH);
  delay(100);
  digitalWrite(RED_LED, LOW);
  digitalWrite(GREEN_LED, HIGH);
  delay(100);
  digitalWrite(RED_LED, HIGH);
  digitalWrite(GREEN_LED, LOW);
  delay(100);
  digitalWrite(RED_LED, LOW);
  digitalWrite(GREEN_LED, HIGH);
  delay(100);
  digitalWrite(GREEN_LED, LOW);
}

void start_listen_mode(void) {
  re_pointer = 0;
  write_pwm(0, 0);
  delay(3000); // 3 seconds buffer for mic cap settling
  timer_mode = MODE_LISTEN;
  setTimer(MODE_LISTEN);
}

void start_drive_mode(void) {
  timer_mode = MODE_DRIVE;
  step_num = 0;
  left_encoder.pos = 0;
  right_encoder.pos = 0;
  setTimer(MODE_DRIVE);
}

/*---------------------------*/
/*    Interrupt functions    */
/*---------------------------*/

#define AVG_DECAY_RATE              0.3
#define LOW_THRESH                  ((int) (0.1*4096))
#define HIGH_THRESH                 ((int) (0.4*4096))

void check_encoder(encoder_t* enc) {
  int new_val = analogRead(enc->pin);
  enc->avg = (int) (AVG_DECAY_RATE*enc->avg + (1 - AVG_DECAY_RATE)*new_val);
  if ((enc->level == LOW && HIGH_THRESH < enc->avg) ||
      (enc->level == HIGH && enc->avg < LOW_THRESH)) {
    enc->pos++;
    enc->level = !enc->level;
  }
}

void check_encoders(void) {
  check_encoder(&left_encoder);
  check_encoder(&right_encoder);
}

// Set timer for timestep; use A2 since A0 & A1 are used by PWM
void setTimer(boolean mode) {
  if (mode == MODE_LISTEN) {
    // Set the timer based on 25MHz clock
    TA2CCR0 = (unsigned int) (25000*ADC_TIMER_MS);
    TA2CCTL0 = CCIE;
    __bis_SR_register(GIE);
    TA2CTL = TASSEL_2 + MC_1 + TACLR + ID_0;
  }
  else if (mode == MODE_DRIVE) {
    TA2CCR0 = (unsigned int) (32.768*SAMPLING_INTERVAL); // set the timer based on 32kHz clock
    TA2CCTL0 = CCIE; // enable interrupts for Timer A
    __bis_SR_register(GIE);
    TA2CTL = TASSEL_1 + MC_1 + TACLR + ID_0;
  }
  timer_mode = mode;
}

// ISR for timestep
#pragma vector=TIMER2_A0_VECTOR    // Timer A ISR
__interrupt void Timer2_A0_ISR(void) {
  if (timer_mode == MODE_LISTEN) {
    if (re_pointer < SIZE) {
      digitalWrite(RED_LED, HIGH);
      re[re_pointer] = (analogRead(MIC_INPUT) >> 4) - 128;
      re_pointer += 1;
    }
  }
  else if (timer_mode == MODE_DRIVE) {
    do_loop = 1;
  }
}
